christianvdstap/dodohand/(list of files, cad)

Other CAD files:
3D_models/axle.h.scad
3D_models/axle.scad
3D_models/clip.h.scad
3D_models/finger.scad
3D_models/finger_guard.scad
3D_models/finger_pcb.scad
3D_models/finger_pcbInfo.scad
3D_models/led_pair.scad
3D_models/lib.h.scad
3D_models/magnet.h.scad
3D_models/magnet.scad
3D_models/pcb.scad
3D_models/thumb.scad
3D_models/tests.scad
3D_models/original/5key_assy.scad
3D_models/original/LiteOn_P_100_E302.scad
3D_models/original/bigkey.scad
3D_models/original/carrier.scad
3D_models/original/dimensions.scad
3D_models/original/guards.scad
3D_models/original/left_fingers.scad
3D_models/original/lever.scad
3D_models/original/plf.scad
3D_models/original/print_rtcluster.scad
3D_models/original/show_assy.scad
3D_models/original/show_carrier.scad
3D_models/original/show_guard.scad
3D_models/original/show_kcb.scad
3D_models/original/show_lowlev.scad
3D_models/original/show_parts.scad
3D_models/original/show_plf.scad
3D_models/original/show_prf.scad
3D_models/original/show_smkey.scad
3D_models/original/show_tcluster.scad
3D_models/original/show_tdds.scad
3D_models/original/show_trp.scad
3D_models/original/tc.scad
3D_models/original/tdds.scad
3D_models/original/tf.scad
3D_models/original/trp.scad
3D_models/original/util.scad
