christianvdstap/dodohand/sch_and_pcb/finger_sch_spi_v1.pdf

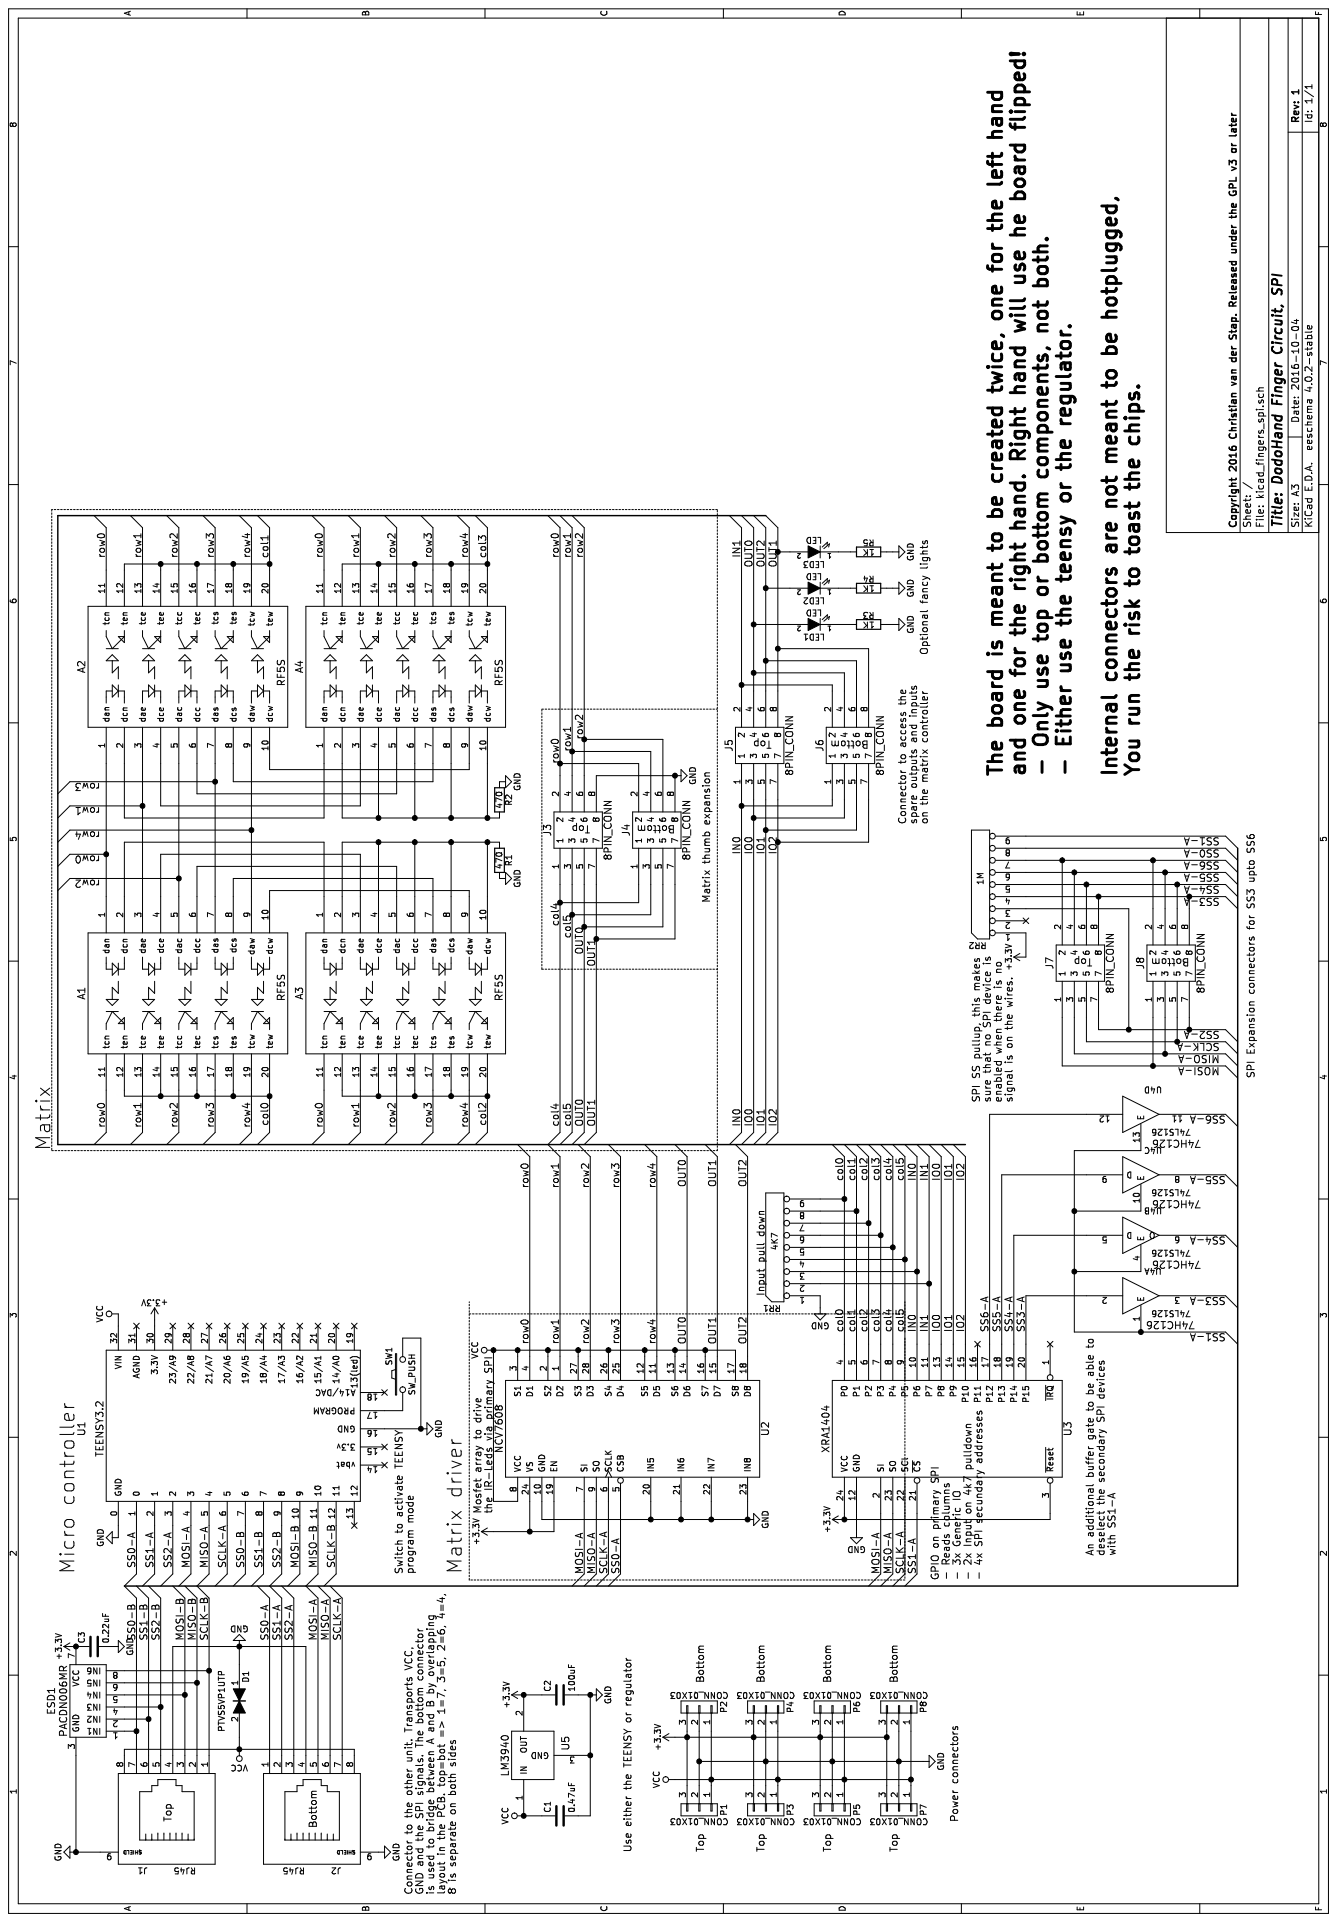
[picture p1: page 1]
