christianvdstap/dodohand/sch_and_pcb/kicad_fingers.kicad_pcb

## KiCad design sch_and_pcb/kicad_fingers.kicad_pcb (2016-08-06)

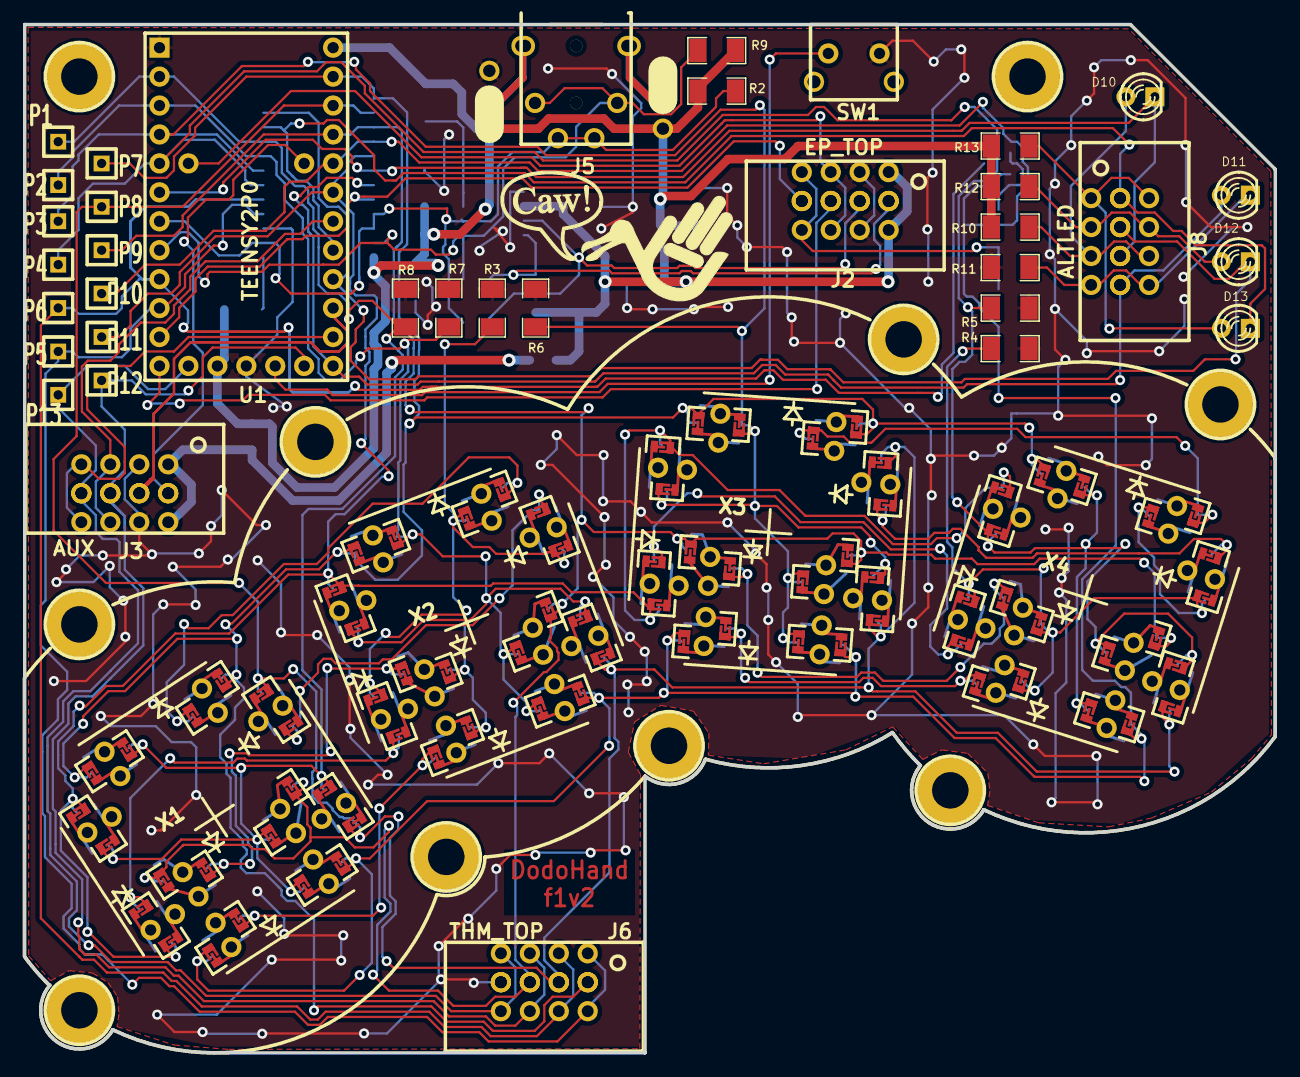
[picture p2: board kicad_fingers.kicad_pcb from above]

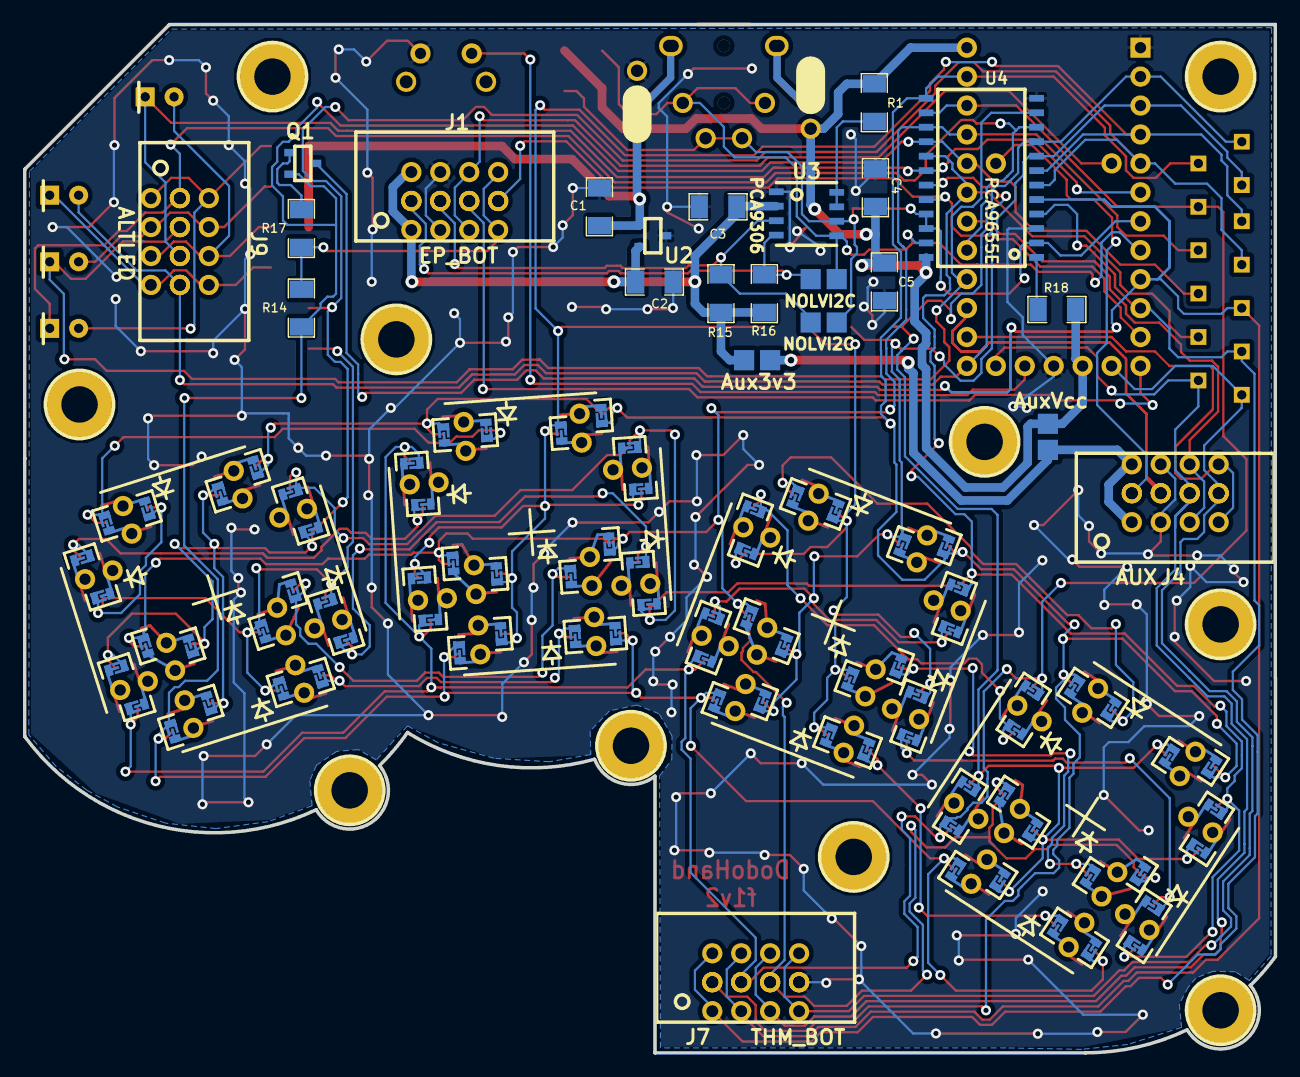
[picture p3: board kicad_fingers.kicad_pcb from below]

Board: 2 copper layers, 109.8 x 90.3 mm, 73 parts (23 on the bottom side), 53 nets.

Parts:
B1: AuxVcc; SOLDER_BR
B2: Aux3v3; SOLDER_BR
B3, B4: NOLVI2C; SOLDER_BR
C1: 4.7; SM1206
C2: 4.7uF; SM1206
C3, C4, C5: 0.1uF; SM1206
D10, D11, D12, D13: LED; LED-3MM-DH
J1: EP_BOT; pth_8_hdr
J2: EP_TOP; pth_8_hdr
J3, J4: AUX; pth_8_hdr
J5: SJ-43514
J6: THM_TOP; pth_8_hdr
J7: THM_BOT; pth_8_hdr
J8, J9: ALTLED; pth_8_hdr
M3_Mounting_Hole, M3_Mounting_Hole#2, M3_Mounting_Hole#3, M3_Mounting_Hole#4, M3_Mounting_Hole#5, M3_Mounting_Hole#6, M3_Mounting_Hole#7, M3_Mounting_Hole#8, M3_Mounting_Hole#9, M3_Mounting_Hole#10: VAL**; M3_Mounting_Hole
P1, P2, P3, P4, P5, P6, P7, P8, P9, P10, P11, P12, P13: TST; SIL-1
Q1: PNP_KSA1298; SOT23
R1: 200k; SM1206
R2, R9, R15, R16: 2.2k; SM1206
R3, R4: 470; SM1206
R5, R6, R7, R8: 2.49k; SM1206
R10, R11, R12, R13: 1k; SM1206
R14, R17: 5k; SM1206
R18: 10k; SM1206
SW1: SPST; PTS645V
U1: TEENSY2P0; TEENSY2p0
U2: LIN_REG; SOT23
U3: PCA9306; SO8
U4: PCA9655E; SOIC24_PCA9655E
X1, X2, X3, X4: RF5S; rf5s

Connections:
+3.3V: B2.1, C2.1, C3.2, J1.2, J2.2, R15.1, R16.1, U2.2, U3.2
/AREF: J3.2, J4.2, U1.AREF
/B4: J3.4, J4.4, U1.B4
/COL0: P1.1, R8.1, U1.B0, U4.9, X1.12, X1.14, X1.16, X1.18, X1.20
/COL1: P2.1, R7.1, U1.B1, U4.8, X2.12, X2.14, X2.16, X2.18, X2.20
/COL2: P3.1, R6.1, U1.B2, U4.7, X3.12, X3.14, X3.16, X3.18, X3.20
/COL3: P4.1, R5.1, U1.B3, U4.6, X4.12, X4.14, X4.16, X4.18, X4.20
/COL4: J6.4, J7.4, P6.1, Q1.3, U1.D2, U4.5
/COL5: J6.2, J7.2, P5.1, U1.D3, U4.4
/D4: J3.6, J4.6, J6.6, J7.6, P12.1, U1.D4
/D5: J3.8, J4.8, J6.8, J7.8, P13.1, U1.D5
/D7: J3.7, J4.7, U1.D7
/EPINT: J1.6, J2.6, U1.E6
/EPRST: J1.7, J2.7, U1.C6, U4.20
/EPSPARE: J1.5, J2.5, U1.C7
/EPSW: J1.8, J2.8, R14.1, R17.1
/F7: J3.5, J4.5, U1.F7
/LED_0: D13.2, J8.1, J9.1, U1.B6, U4.10
/LED_1: D12.2, J8.3, J9.3, U1.B5, U4.11
/LED_2: D10.2, J8.5, J9.5, U1.B7, U4.18
/LED_D6_3: D11.1, J8.7, J9.7, U1.D6, U4.19
/LVSCL: B4.2, J1.3, J2.3, R15.2, U3.3
/LVSDA: B3.2, J1.1, J2.1, R16.2, U3.4
/ROW0: J6.1, J7.1, P7.1, U1.F0, U4.13, X1.1, X1.11, X2.11, X3.1, X3.11, X4.11
/ROW1: J6.3, J7.3, P8.1, U1.F1, U4.14, X1.3, X1.13, X2.13, X3.3, X3.13, X4.13
/ROW2: J6.5, J7.5, P9.1, U1.F4, U4.15, X1.5, X1.15, X2.15, X3.5, X3.15, X4.15
/ROW3: P10.1, Q1.2, R14.2, U1.F5, U4.16, X1.7, X1.17, X2.17, X3.7, X3.17, X4.17
/ROW4: P11.1, U1.F6, U4.17, X1.9, X1.19, X2.19, X3.9, X3.19, X4.19
/SCL: B4.1, J5.3, R2.2, U1.D0, U3.6, U4.2, U4.21, U4.22
/SDA: B3.1, J5.2, R9.2, U1.D1, U3.5, U4.23
/TRST: SW1.1, U1.RST
GND: C1.2, C2.2, C3.1, C4.2, C5.2, J1.4, J2.4, J3.3, J4.3, J5.1, J6.7, J7.7, R3.2, R4.2, R5.2, R6.2, R7.2, R8.2, R11.2, SW1.2, U1.GND, U2.3, U3.1, U4.3, U4.12
unnamed: D10.1, J8.6, J9.6, R10.2
unnamed: D11.2, J8.8, J9.8, R11.1
unnamed: D12.1, J8.4, J9.4, R12.2
unnamed: D13.1, J8.2, J9.2, R13.2
unnamed: Q1.1, R17.2
unnamed: R1.1, U3.7, U3.8
unnamed: R3.1, X2.2, X2.4, X2.6, X2.8, X2.10
unnamed: R4.1, X4.2, X4.4, X4.6, X4.8, X4.10
unnamed: R18.2, U4.1
unnamed: X1.2, X2.1
unnamed: X1.4, X2.3
unnamed: X1.6, X2.5
unnamed: X1.8, X2.7
unnamed: X1.10, X2.9
unnamed: X3.2, X4.1
unnamed: X3.4, X4.3
unnamed: X3.6, X4.5
unnamed: X3.8, X4.7
unnamed: X3.10, X4.9
VCC: B1.1, C1.1, C4.1, C5.1, J5.4, R1.2, R2.1, R9.1, R10.1, R12.1, R13.1, R18.1, U1.Vcc, U2.1, U4.24
VCOM: B1.2, B2.2, J3.1, J4.1
