christianvdstap/dodohand/(commit log)

2016-07-26 Changed the resistor pads to the same solder bridges as the thumb unit. Changed the footprint on the board and fixed the tracks.
    [kicad_fingers.kicad_pcb]
2016-07-26 Increased the gaps to 6mil
    [kicad_fingers.kicad_pcb]
2016-08-06 Fixed the silkscreen on rf5s and moved back to gaps of 5mil. PCB New complains about unconnected pads which seems to be false positives.
    [kicad_fingers.kicad_pcb]
2016-08-23 Moved original scad files to a sub dir
    [5key_assy.scad, LiteOn_P_100_E302.scad, bigkey.scad, carrier.scad, dimensions.scad, guards.scad, left_fingers.scad, lever.scad]
2016-08-23 First commit of the alternative for the finger unit.
    [axle.h.scad, axle.scad, clip.h.scad, clip.scad, finger.h.scad, finger.scad, finger_carrier.scad, finger_centerKey.scad]
2016-08-30 Added initial version of the fingerunit which is based on SPI and 3.3v.
    [kicad_fingers_spi.sch]
2016-08-30 Fixed an issue where the secondary spi addresses could block the bus.
    [kicad_fingers_spi.sch]
2016-10-04 Added the thumb carrier. Some small refactoring to reuse part of the finger work
    [finger.h.scad, finger.scad, finger_carrier.scad, finger_centerKey.scad, finger_pcb.scad, led_pair.scad, lib.h.scad, lib.scad]
2016-10-04 Added pdf version of the finger spi unit v1
2016-11-27 Initial version of the thumb unit
    [lib.h.scad, lib.scad, math.scad, pcb.scad, tests.scad, thumb.h.scad, thumb.scad, thumb_carrier.scad]
2016-12-10 Added clearance for screw heads on the thumb side carriers
    [tests.scad, thumb_side.scad]
2016-12-21 Fixed an issue where the lens could not slide over the inner part of the thumb side carrier
    [lib.scad, tests.scad, thumb_side.scad]
